arjepsen/TAC5212_HAT/production/bom.csv

Designator | Footprint | Quantity | Value | LCSC Part #
C1, C13, C4, C5, C7, C9 | 0805 | 6 | 10uF | CL21A106KAYNNNE
C10, C12, C2, C6, C8 | 0603 | 5 | 100nF | CC0603KRX7R9BB104
C11 | 0805 | 1 | 1uF | CL21B105KBFNNNE
C14 | 1206 | 1 | 100nF | 1206CG104J500NT
C15 | 0603 | 1 | 22pF | CL10C220JB8NNNC
C16, C17 | 1206 | 2 | 4.7uF | 1206B475K500NT
C18, C19 | CP_Radial_D8.0mm_P3.50mm | 2 | 680uF | EEU-FR1A681
C3 | 0805 | 1 | 4.7uF | CL21A475KAQNNNE
D1, D2 | D_SOD-523 | 2 | TVS | PESD5V0U1BB,115
FB1 | 0805 | 1 | 220R@100MHz | BLM21PG221SN1D
FB2 | 0603 | 1 | 600R@100MHz | BLM18SP601SN1D
IC1 | TAC5212IRGER_Custom | 1 | TAC5212IRGER | TAC5212IRGER
JP1 | 0603 | 1 | 0R | RC0603JR-070RL
R1 | 0603 | 1 | 33.2k | RT0603BRD0733K2L
R11, R13, R14, R17, R18 | 0402 | 5 | 10K | RC0402FR-0710KL
R12 | 0603 | 1 | 100K | RC0603FR-07100KL
R15, R16 | 0402 | 2 | 100R | RC0402FR-07100RL
R19 | 0402 | 1 | 100K | RC0402FR-07100KL
R2 | 0402 | 1 | 33R | RC0402FR-0733RL
R3, R4 | 0603 | 2 | 10K | RC0603FR-0710KL
R5 | 0603 | 1 | 1K | RC0603FR-071KL
R6 | 0603 | 1 | 1M | 0603WAF1004T5E
R7, R8 | 0603 | 2 | 5.1K | CRCW06035K10FKEA
U1 | MSOP-10-1EP_3x3mm_P0.5mm_EP1.68x1.88mm | 1 | LT3042 | LT3042EMSE#PBF
U2 | SOIC-8_3.9x4.9mm_P1.27mm | 1 | OPA2365 | OPA2365AIDR
