arjepsen/TAC5212_HAT/production/JLCPCB_BOM_CORRECTED.csv

Comment | Designator | Footprint | JLCPCB Part #
10uF | C1 | C_0805_2012Metric | C15850
100nF | C2 | C_0603_1608Metric | C14663
4.7uF | C3 | C_0805_2012Metric | C1779
10uF | C4 | C_0805_2012Metric | C15850
10uF | C5 | C_0805_2012Metric | C15850
100nF | C6 | C_0603_1608Metric | C14663
10uF | C7 | C_0805_2012Metric | C15850
100nF | C8 | C_0603_1608Metric | C14663
10uF | C9 | C_0805_2012Metric | C15850
100nF | C10 | C_0603_1608Metric | C14663
1uF | C11 | C_0805_2012Metric | C28323
100nF | C12 | C_0603_1608Metric | C14663
10uF | C13 | C_0805_2012Metric | C15850
100nF | C14 | C_1206_3216Metric | C46348
22pF | C15 | C_0603_1608Metric | C1653
4.7uF | C16 | C_1206_3216Metric | C29823
4.7uF | C17 | C_1206_3216Metric | C29823
TVS | D1 | D_SOD-523 | C85388
TVS | D2 | D_SOD-523 | C85388
220R@100MHz | FB1 | L_0805_2012Metric | C85840
600R@100MHz | FB2 | L_0603_1608Metric | C3716583
TAC5212IRGER | IC1 | TAC5212IRGER_Custom | C44853694
0R | JP1 | R_0603_1608Metric | C21189
33.2k | R1 | R_0603_1608Metric | C705767
33R | R2 | R_0402_1005Metric | C25105
10K | R3 | R_0603_1608Metric | C25804
10K | R4 | R_0603_1608Metric | C25804
1K | R5 | R_0603_1608Metric | C21190
1M | R6 | R_0603_1608Metric | C22935
5.1K | R7 | R_0603_1608Metric | C23186
5.1K | R8 | R_0603_1608Metric | C23186
10K | R11 | R_0402_1005Metric | C25744
100K | R12 | R_0603_1608Metric | C25803
10K | R13 | R_0402_1005Metric | C25744
10K | R14 | R_0402_1005Metric | C25744
100R | R15 | R_0402_1005Metric | C25076
100R | R16 | R_0402_1005Metric | C25076
10K | R17 | R_0402_1005Metric | C25744
10K | R18 | R_0402_1005Metric | C25744
100K | R19 | R_0402_1005Metric | C25741
LT3042EMSE#PBF | U1 | MSOP-10-1EP_3x3mm_P0.5mm_EP1.68x1.88mm | C69847
OPA2365 | U2 | SOIC-8_3.9x4.9mm_P1.27mm | C130011
680uF 10V Panasonic EEU-FR1A681 radial THT | C18 | CP_Radial_D8.0mm_P3.50mm | C407875
680uF 10V Panasonic EEU-FR1A681 radial THT | C19 | CP_Radial_D8.0mm_P3.50mm | C407875
