arjepsen/TAC5212_HAT/temporary/BOM_GROUPED_for_2_boards.csv

Designators | Qty_Per_PCB | Qty_For_2_PCBs | Value | Footprint | Manufacturer_Part | JLCPCB_LCSC_Part | Status | AssemblyStatus
C1,C4,C5,C7,C9,C13 | 6 | 12 | 10uF | Capacitor_SMD:C_0805_2012Metric | CL21A106KAYNNNE | C15850 | SMT_ASSY_QUOTE
C2,C6,C8,C10,C12 | 5 | 10 | 100nF | Capacitor_SMD:C_0603_1608Metric | CC0603KRX7R9BB104 | C14663 | SMT_ASSY_QUOTE
C3 | 1 | 2 | 4.7uF | Capacitor_SMD:C_0805_2012Metric | CL21A475KAQNNNE | C1779 | SMT_ASSY_QUOTE
C11 | 1 | 2 | 1uF | Capacitor_SMD:C_0805_2012Metric | CL21B105KBFNNNE | C28323 | SMT_ASSY_QUOTE
C14 | 1 | 2 | 100nF | Capacitor_SMD:C_1206_3216Metric | 1206CG104J500NT | C46348 | SMT_ASSY_QUOTE
C15 | 1 | 2 | 22pF | Capacitor_SMD:C_0603_1608Metric | CL10C220JB8NNNC | C1653 | SMT_ASSY_QUOTE
C16,C17 | 2 | 4 | 4.7uF | Capacitor_SMD:C_1206_3216Metric | 1206B475K500NT | C29823 | SMT_ASSY_QUOTE
C18,C19 | 2 | 4 | 680uF | Capacitor_THT:CP_Radial_D8.0mm_P3.50mm | EEU-FR1A681 | C407875 | HAND_SOLDER_THT | THT_ASSY_QUOTE_PENDING_JLC_ACCEPTANCE
C20,C21 | 2 | 4 | 100uF | Capacitor_THT:CP_Radial_D5.0mm_P2.00mm | EEU-FR1C101 | C278532 | HAND_SOLDER_THT | DNP_FOR_QUOTE_ONLY
D1,D2 | 2 | 4 | TVS | Diode_SMD:D_SOD-523 | PESD5V0U1BB,115 | C85388 | SMT_ASSY_QUOTE
FB1 | 1 | 2 | 220R@100MHz | Inductor_SMD:L_0805_2012Metric | BLM21PG221SN1D | C85840 | SMT_ASSY_QUOTE
FB2 | 1 | 2 | 600R@100MHz | Inductor_SMD:L_0603_1608Metric | BLM18SP601SN1D | C3716583 | SMT_ASSY_QUOTE
IC1 | 1 | 2 | TAC5212IRGER | Audio_HAT_Custom:TAC5212IRGER_Custom | TAC5212IRGER | C44853694 | SMT_ASSY_QUOTE
J1 | 1 | 2 | GPIO Connector | Connector_PinSocket_2.54mm:PinSocket_2x20_P2.54mm_Vertical | 2.54-2*20 | C2977589 | HAND_SOLDER_THT | HAND_SOLDER_BOTTOM
J2 | 1 | 2 | Guitar | AudioHAT_Wire:Wire_0.15mm2_1x02_P2.54mm_D0.8mm |  |  | HAND_SOLDER_THT
J3 | 1 | 2 | Line | AudioHAT_Wire:Wire_0.15mm2_1x02_P2.54mm_D0.8mm |  |  | HAND_SOLDER_THT
J4 | 1 | 2 | Headphones | AudioHAT_Wire:Wire_0.15mm2_1x03_P2.54mm_D0.8mm |  |  | HAND_SOLDER_THT
J5 | 1 | 2 | Line-out-L | AudioHAT_Wire:Wire_0.15mm2_1x02_P2.54mm_D0.8mm |  |  | HAND_SOLDER_THT
J6 | 1 | 2 | Line-out-R | AudioHAT_Wire:Wire_0.15mm2_1x02_P2.54mm_D0.8mm |  |  | HAND_SOLDER_THT
JP1 | 1 | 2 | 0R | Resistor_SMD:R_0603_1608Metric | 0603WAF0000T5E | C21189 | SMT_ASSY_QUOTE
R1 | 1 | 2 | 33.2k | Resistor_SMD:R_0603_1608Metric | RT0603BRD0733K2L | C705767 | SMT_ASSY_QUOTE
R2 | 1 | 2 | 33R | Resistor_SMD:R_0402_1005Metric | 0402WGF330JTCE | C25105 | SMT_ASSY_QUOTE
R3,R4 | 2 | 4 | 10K | Resistor_SMD:R_0603_1608Metric | 0603WAF1002T5E | C25804 | SMT_ASSY_QUOTE
R5 | 1 | 2 | 1K | Resistor_SMD:R_0603_1608Metric | 0603WAF1001T5E | C21190 | SMT_ASSY_QUOTE
R6 | 1 | 2 | 1M | Resistor_SMD:R_0603_1608Metric | 0603WAF1004T5E | C22935 | SMT_ASSY_QUOTE
R7,R8 | 2 | 4 | 5.1K | Resistor_SMD:R_0603_1608Metric | 0603WAF5101T5E | C23186 | SMT_ASSY_QUOTE
R9 | 1 | 2 | 750K | Resistor_SMD:R_0603_1608Metric | RC0603FR-07750KL | C137684 | DNP
R10 | 1 | 2 | 330K | Resistor_SMD:R_0603_1608Metric | 0603WAF3303T5E | C23137 | DNP
R11,R13,R14,R17,R18 | 5 | 10 | 10K | Resistor_SMD:R_0402_1005Metric | 0402WGF1002TCE | C25744 | SMT_ASSY_QUOTE
R12 | 1 | 2 | 100K | Resistor_SMD:R_0603_1608Metric | 0603WAF1003T5E | C25803 | SMT_ASSY_QUOTE
R15,R16 | 2 | 4 | 100R | Resistor_SMD:R_0402_1005Metric | 0402WGF1000TCE | C25076 | SMT_ASSY_QUOTE
R19 | 1 | 2 | 100K | Resistor_SMD:R_0402_1005Metric | 0402WGF1003TCE | C25741 | SMT_ASSY_QUOTE
U1 | 1 | 2 | LT3042 | Package_SO:MSOP-10-1EP_3x3mm_P0.5mm_EP1.68x1.88mm |  |  | SMT_ASSY_NEEDS_PART_MATCH
U2 | 1 | 2 | OPA2365 | Package_SO:SOIC-8_3.9x4.9mm_P1.27mm | OPA2365AIDR | C130011 | SMT_ASSY_QUOTE
