arjepsen/TAC5212_HAT/Audio_HAT.kicad_pcb

## KiCad design Audio_HAT.kicad_pcb (2026-10-24)

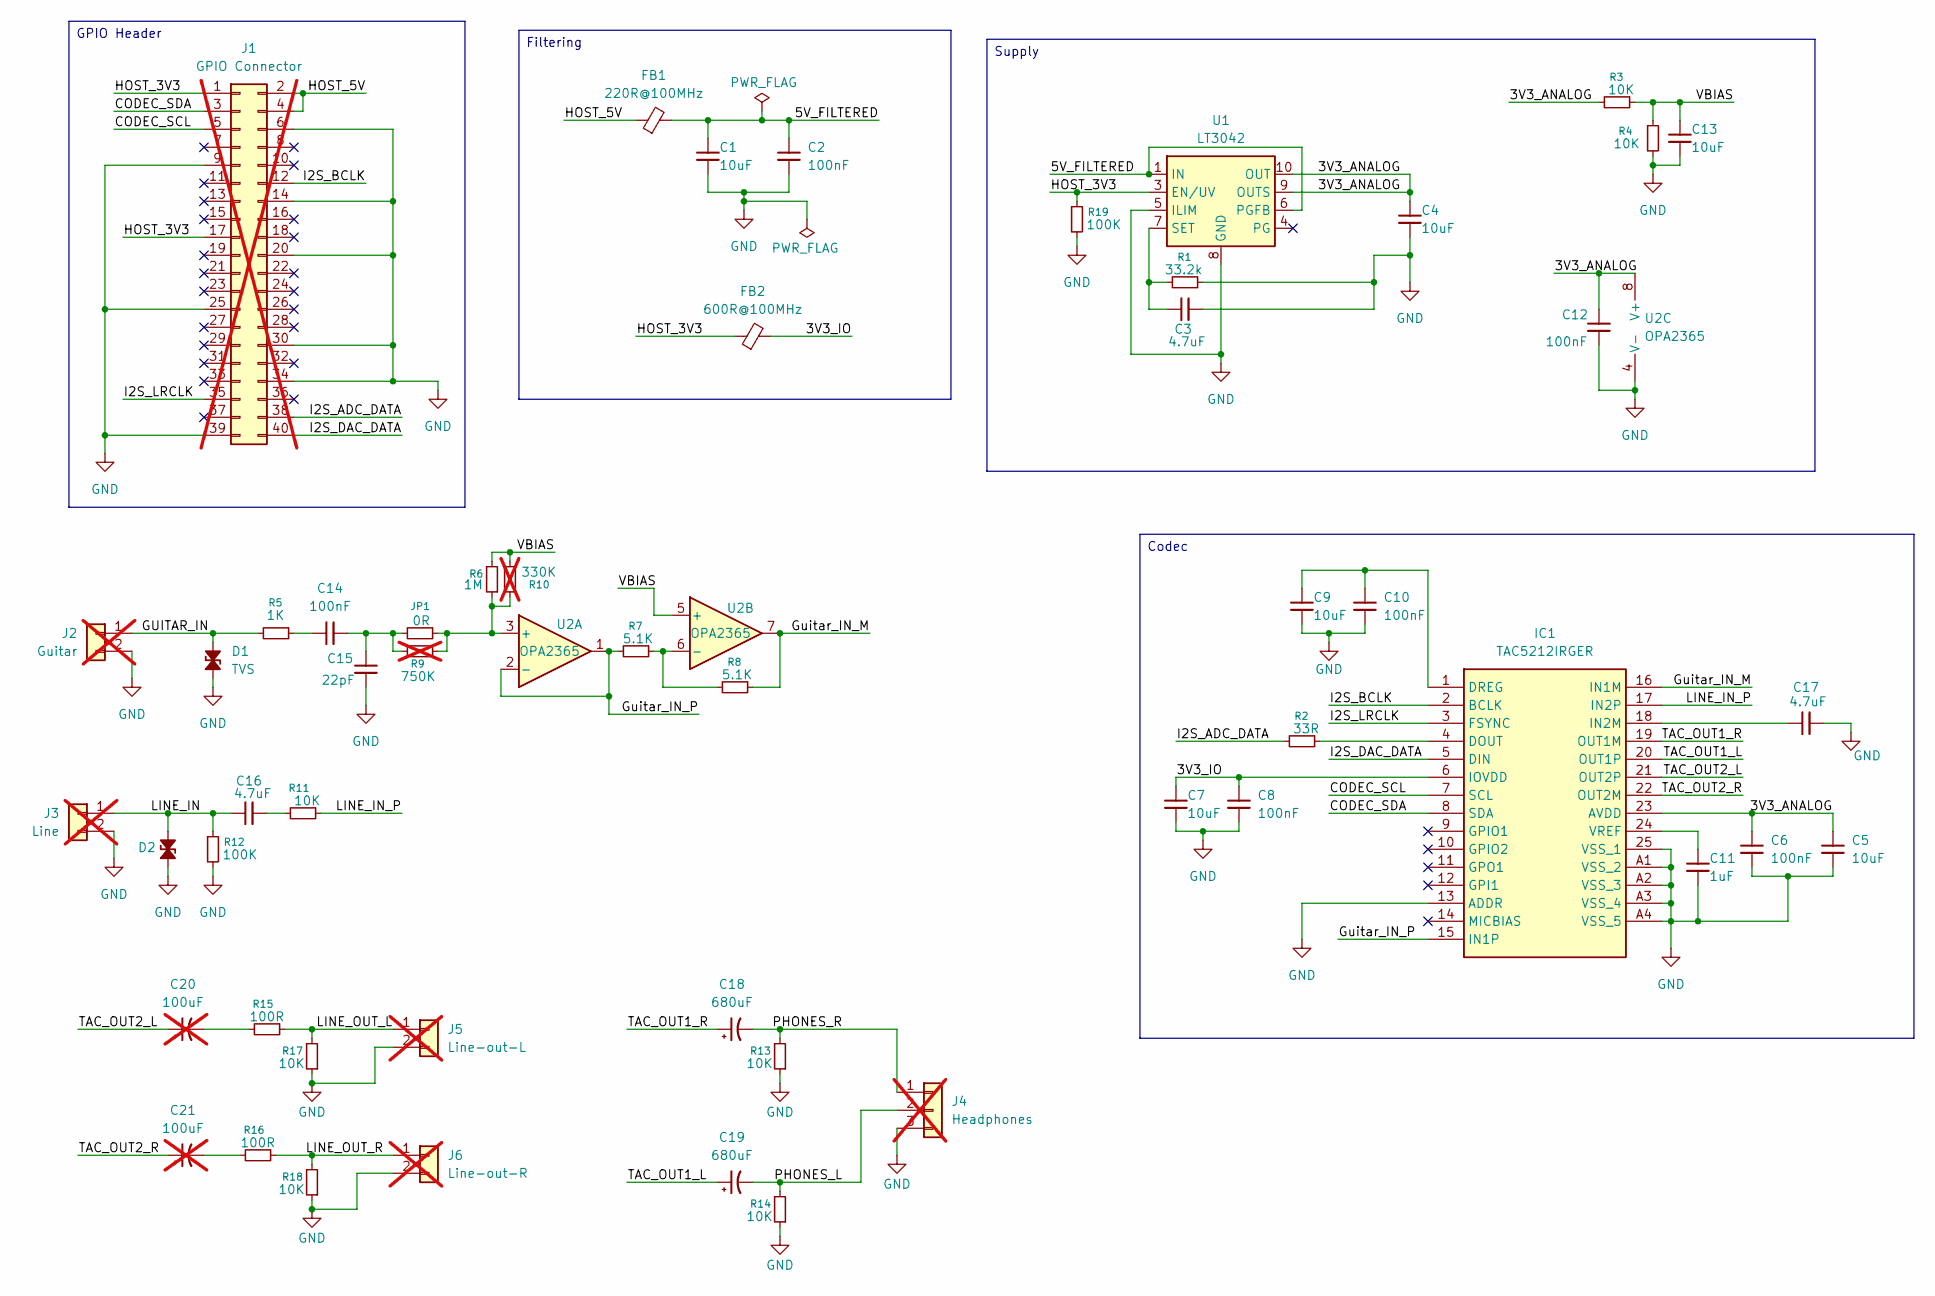
[picture p1: schematic Audio_HAT.kicad_sch]

Parts:
C1, C4, C5, C7, C9, C13: 10uF; C_0805_2012Metric; Manufacturer part CL21A106KAYNNNE; JLCPCB part C15850
C2, C6, C8, C10, C12: 100nF; C_0603_1608Metric; Manufacturer part CC0603KRX7R9BB104; JLCPCB part C14663
C3: 4.7uF; C_0805_2012Metric; Manufacturer part CL21A475KAQNNNE; JLCPCB part C1779
C11: 1uF; C_0805_2012Metric; Manufacturer part CL21B105KBFNNNE; JLCPCB part C28323
C14: 100nF; C_1206_3216Metric; Manufacturer part 1206CG104J500NT; JLCPCB part C46348
C15: 22pF; C_0603_1608Metric; Manufacturer part CL10C220JB8NNNC; JLCPCB part C1653
C16, C17: 4.7uF; C_1206_3216Metric; Manufacturer part 1206B475K500NT; JLCPCB part C29823
C18, C19: 680uF; CP_Radial_D8.0mm_P3.50mm; Manufacturer part EEU-FR1A681; JLCPCB part C407875
C20, C21: 100uF; CP_Radial_D5.0mm_P2.00mm; Manufacturer part EEU-FR1C101; JLCPCB part C278532; not fitted
D1, D2: TVS; D_SOD-523; Manufacturer part PESD5V0U1BB,115; JLCPCB part C85388
FB1: 220R@100MHz; L_0805_2012Metric; Manufacturer Part BLM21PG221SN1D
FB2: 600R@100MHz; L_0603_1608Metric; Manufacturer Part BLM18SP601SN1D
IC1: TAC5212IRGER; TAC5212IRGER_Custom; Manufacturer part TAC5212IRGER; JLCPCB part C44853694
J1: GPIO Connector; PinSocket_2x20_P2.54mm_Vertical; Manufacturer part 2.54-2*20; JLCPCB part C2977589; not fitted
J2: Guitar; Wire_0.15mm2_1x02_P2.54mm_D0.8mm; not fitted
J3: Line; Wire_0.15mm2_1x02_P2.54mm_D0.8mm; not fitted
J4: Headphones; Wire_0.15mm2_1x03_P2.54mm_D0.8mm; not fitted
J5: Line-out-L; Wire_0.15mm2_1x02_P2.54mm_D0.8mm; not fitted
J6: Line-out-R; Wire_0.15mm2_1x02_P2.54mm_D0.8mm; not fitted
JP1: 0R; R_0603_1608Metric; Manufacturer part RC0603JR-070RL; JLCPCB part C21189
R1: 33.2k; R_0603_1608Metric; Manufacturer part RT0603BRD0733K2L; JLCPCB part C705767
R2: 33R; R_0402_1005Metric; Manufacturer part RC0402FR-0733RL; JLCPCB part C25105
R3, R4: 10K; R_0603_1608Metric; Manufacturer part RC0603FR-0710KL; JLCPCB part C25804
R5: 1K; R_0603_1608Metric; Manufacturer part RC0603FR-071KL; JLCPCB part C21190
R6: 1M; R_0603_1608Metric; Manufacturer part 0603WAF1004T5E; JLCPCB part C22935
R7, R8: 5.1K; R_0603_1608Metric; Manufacturer part CRCW06035K10FKEA; JLCPCB part C23186
R9: 750K; R_0603_1608Metric; Manufacturer part RC0603FR-07750KL; JLCPCB part C137684; not fitted
R10: 330K; R_0603_1608Metric; Manufacturer part 0603WAF3303T5E; JLCPCB part C23137; not fitted
R11, R13, R14, R17, R18: 10K; R_0402_1005Metric; Manufacturer part RC0402FR-0710KL; JLCPCB part C25744
R12: 100K; R_0603_1608Metric; Manufacturer part RC0603FR-07100KL; JLCPCB part C25803
R15, R16: 100R; R_0402_1005Metric; Manufacturer part RC0402FR-07100RL; JLCPCB part C25076
R19: 100K; R_0402_1005Metric; Manufacturer part RC0402FR-07100KL; JLCPCB part C25741
U1: LT3042; MSOP-10-1EP_3x3mm_P0.5mm_EP1.68x1.88mm; MPN LT3042EMSE#PBF
U2: OPA2365; SOIC-8_3.9x4.9mm_P1.27mm; Manufacturer part OPA2365AIDR; JLCPCB part C130011

Connections:
/3V3_ANALOG: C4.1, C5.1, C6.1, C12.1, IC1.23 (AVDD), R3.2, U1.9 (OUTS), U1.10 (OUT), U2.8 (V+)
/3V3_IO: C7.1, C8.1, FB2.2, IC1.6 (IOVDD)
/5V_FILTERED: C1.1, C2.1, FB1.2, U1.1 (IN), U1.2 (IN), U1.6 (PGFB)
/CODEC_SCL: IC1.7 (SCL), J1.5
/CODEC_SDA: IC1.8 (SDA), J1.3
/GUITAR_IN: D1.2 (A2), J2.1, R5.2
/Guitar_IN_M: IC1.16 (IN1M), R8.1, U2.7
/Guitar_IN_P: IC1.15 (IN1P), R7.2, U2.1, U2.2 (-)
/HOST_3V3: FB2.1, J1.1, J1.17, R19.1, U1.3 (EN/UV)
/HOST_5V: FB1.1, J1.2, J1.4
/I2S_ADC_DATA: J1.38, R2.2
/I2S_BCLK: IC1.2 (BCLK), J1.12
/I2S_DAC_DATA: IC1.5 (DIN), J1.40
/I2S_LRCLK: IC1.3 (FSYNC), J1.35
/LINE_IN: C16.1, D2.2 (A2), J3.1, R12.1
/LINE_IN_P: IC1.17 (IN2P), R11.1
/LINE_OUT_L: J5.1, R15.1, R17.2
/LINE_OUT_R: J6.1, R16.1, R18.2
/PHONES_L: C19.2, J4.2, R14.2
/PHONES_R: C18.2, J4.1, R13.2
/TAC_OUT1_L: C19.1, IC1.20 (OUT1P)
/TAC_OUT1_R: C18.1, IC1.19 (OUT1M)
/TAC_OUT2_L: C20.1, IC1.21 (OUT2P)
/TAC_OUT2_R: C21.1, IC1.22 (OUT2M)
/VBIAS: C13.1, R3.1, R4.1, R6.2, R10.2, U2.5 (+)
GND: C1.2, C2.2, C3.2, C4.2, C5.2, C6.2, C7.2, C8.2, C9.2, C10.2, C11.2, C12.2, C13.2, C15.2, C17.2, D1.1 (A1), D2.1 (A1), IC1.13 (ADDR), IC1.25 (VSS_1), IC1.A1 (VSS_2), IC1.A2 (VSS_3), IC1.A3 (VSS_4), IC1.A4 (VSS_5), J1.6, J1.9, J1.14, J1.20, J1.25, J1.30, J1.34, J1.39, J2.2, J3.2, J4.3, J5.2, J6.2, R1.1, R4.2, R12.2, R13.1, R14.1, R17.1, R18.1, R19.2, U1.5 (ILIM), U1.8 (GND), U1.11 (GND), U2.4 (V-)
unnamed: C14.1, R5.1
unnamed: C14.2, C15.1, JP1.2, R9.2
unnamed: C16.2, R11.2
unnamed: C20.2, R15.2
unnamed: C21.2, R16.2
unnamed: IC1.4 (DOUT), R2.1
unnamed: C9.1, C10.1, IC1.1 (DREG)
unnamed: C17.1, IC1.18 (IN2M)
unnamed: C11.1, IC1.24 (VREF)
unnamed: C3.1, R1.2, U1.7 (SET)
unnamed: JP1.1, R6.1, R9.1, R10.1, U2.3 (+)
unnamed: R7.1, R8.2, U2.6 (-)

Notes on the sheet:
Codec
Supply
GPIO Header
Filtering

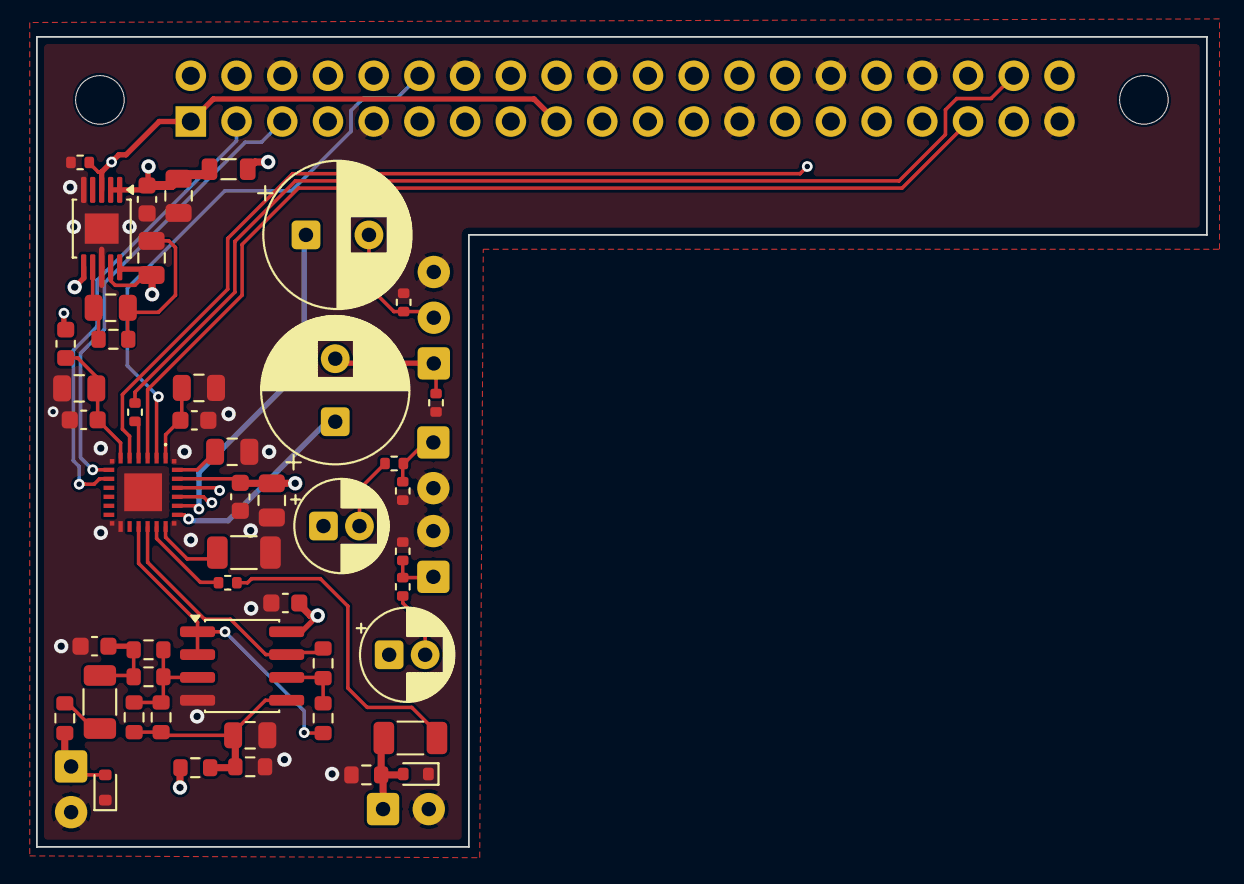
[picture p2: board Audio_HAT.kicad_pcb from above]

Board: 4 copper layers, 65.0 x 45.0 mm, 54 parts (1 on the bottom side), 38 nets.
